gregdavill/icebreaker/hardware/bitsy-v0.3b/icebreaker-bitsy_back.jpg

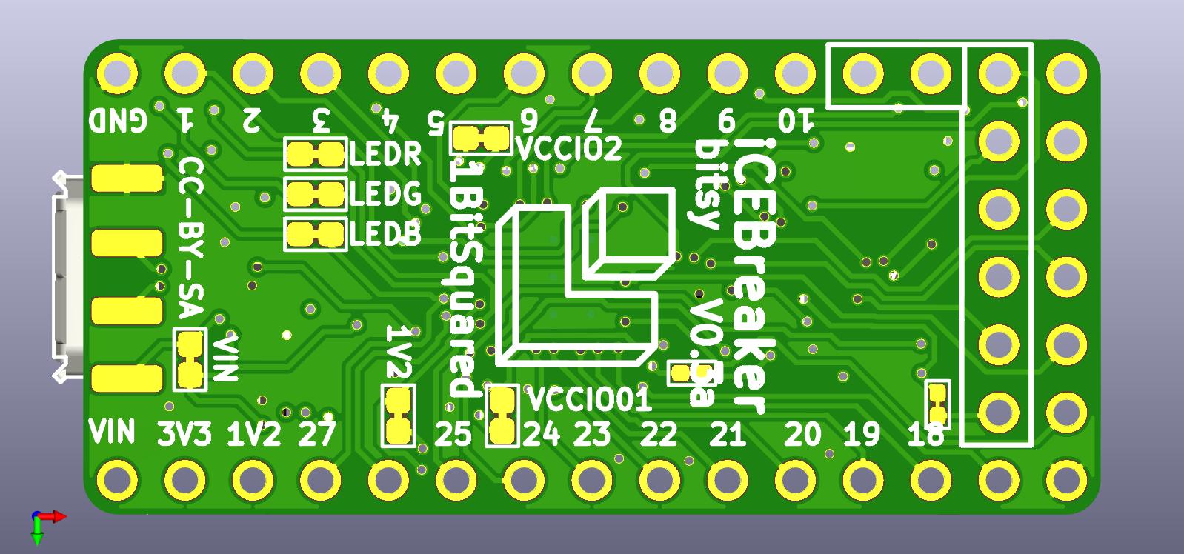
hardware/bitsy-v0.3b/icebreaker-bitsy_back.jpg
