gregdavill/icebreaker/hardware/bitsy-v0.3b/icebreaker-bitsy.jpg

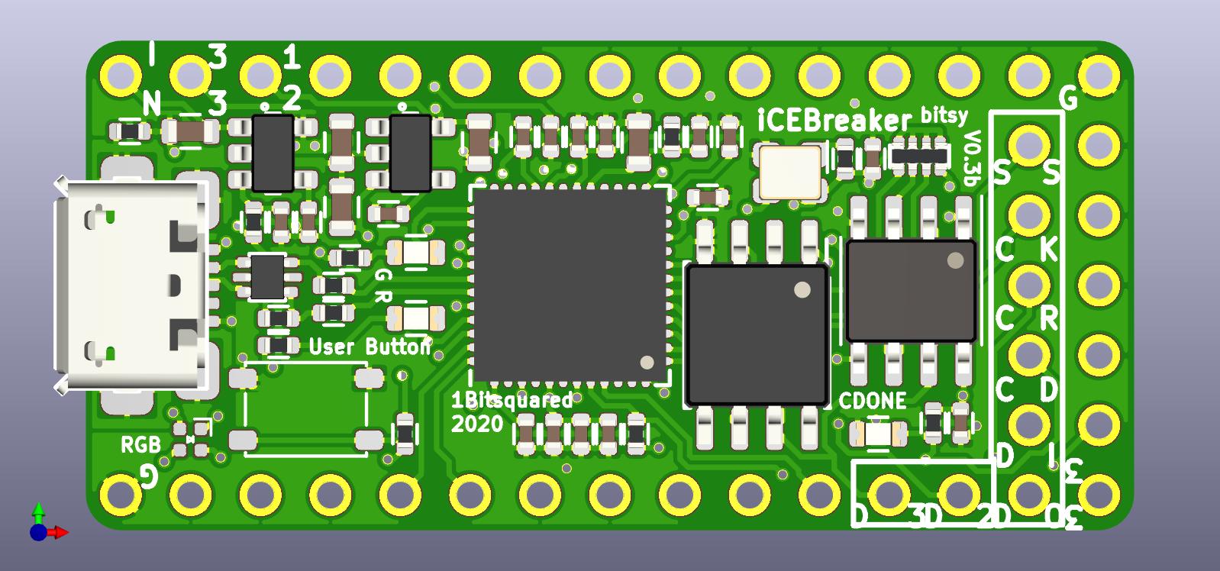
hardware/bitsy-v0.3b/icebreaker-bitsy.jpg
