gregdavill/icebreaker/hardware/bitsy-v0.3b/icebreaker-bitsy-sch.pdf

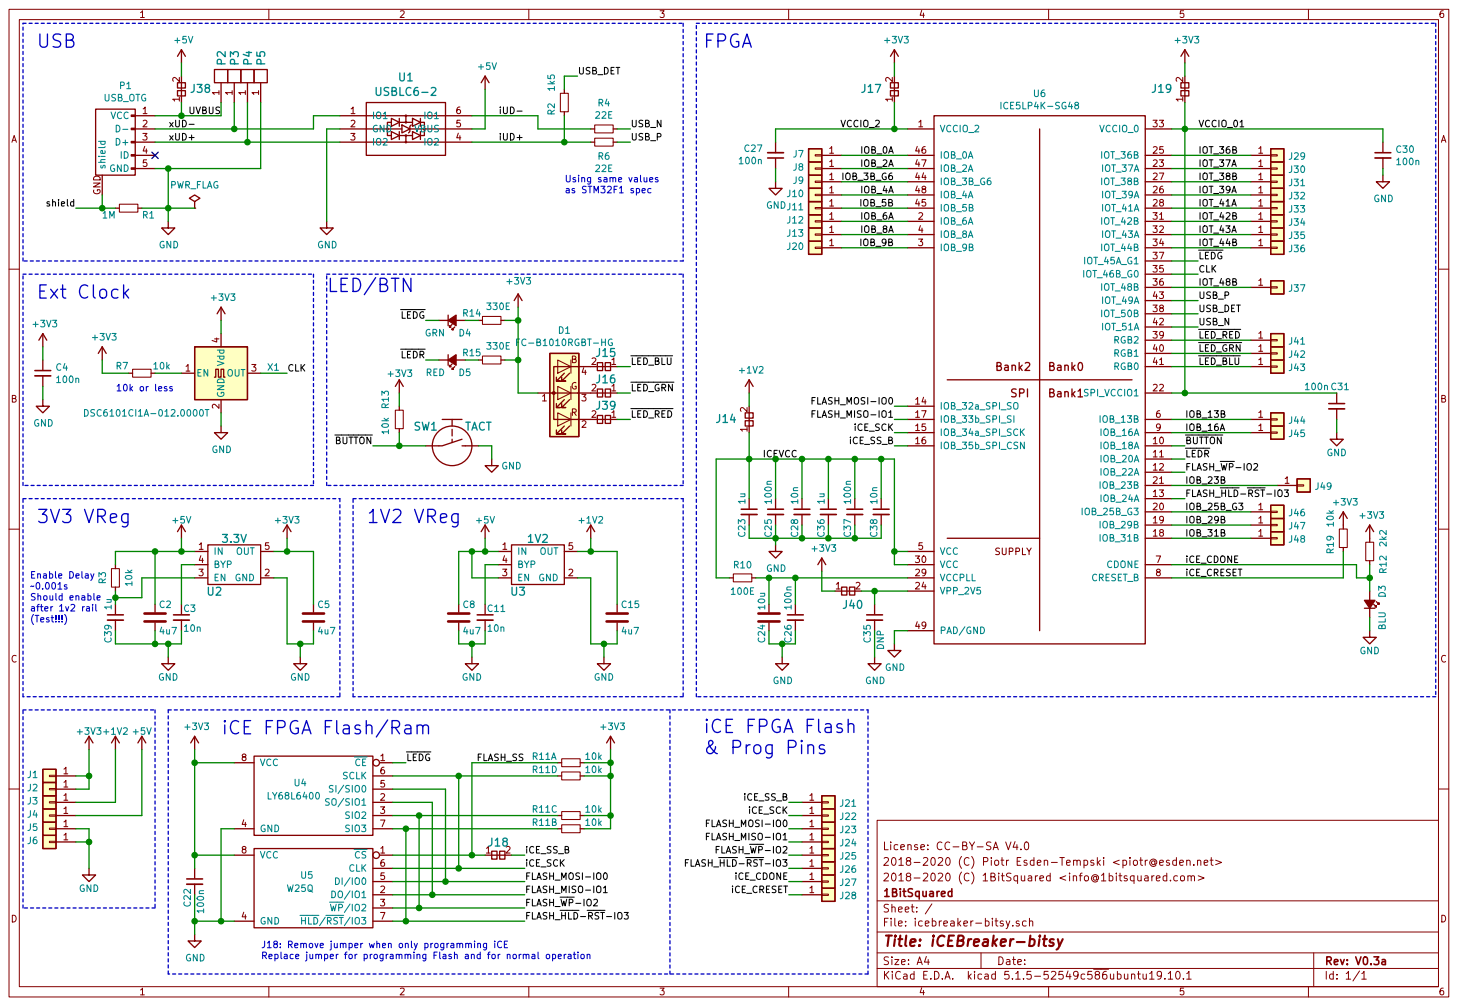
[picture p3: page 1]

LED_GRN 1
LED_BLU 1

Enable Delay 0.001s Should enable

iCE FPGA Flash/Ram

License: CC-BY-SA V4.0
2018-2020 (C) Piotr Esden-Tempski <piotr@esden.net>
2018-2020 (C) 1BitSquared <info@1bitsquared.com>
File: icebreaker-bitsy.sch Sheet: / 1BitSquared

Id: 1/1 Title: iCEBreaker-bitsy

J18: Remove jumper when only programming iCE
Replace jumper for programming Flash and for normal operation
