gregdavill/icebreaker/hardware/bitsy-v0.3b/icebreaker-bitsy.kicad_pcb

## KiCad design hardware/bitsy-v0.3b/icebreaker-bitsy.kicad_pcb (2020-04-05)

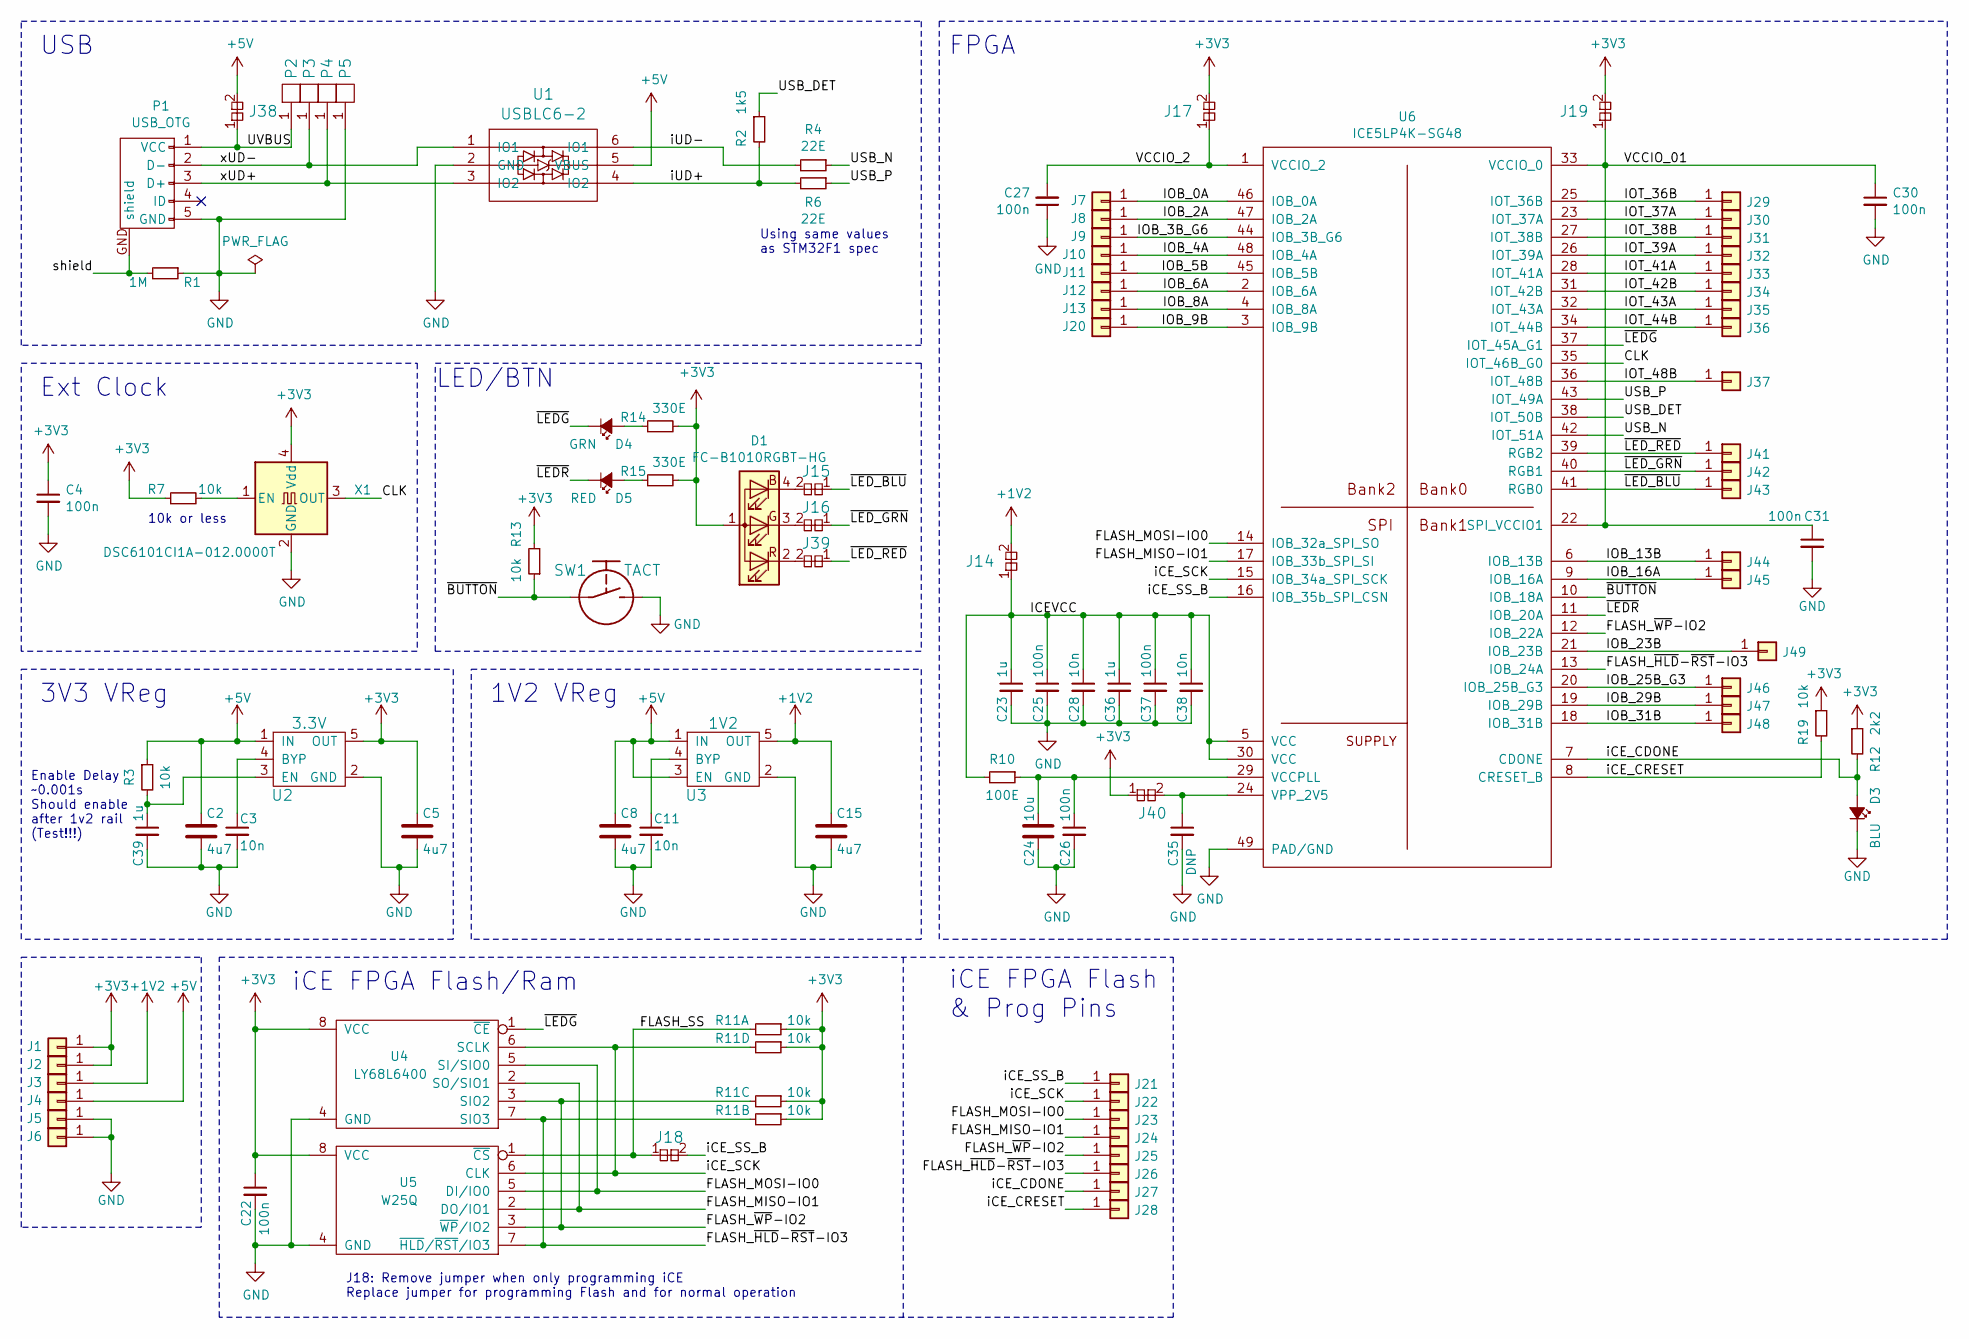
[picture p4: schematic icebreaker-bitsy.sch]

Parts:
C2, C5, C8, C15: 4u7; C_0603
C3, C11, C28, C38: 10n; C_0402
C4, C22, C25, C26, C27, C30, C31, C37: 100n; C_0402
C23, C36, C39: 1u; C_0402
C24: 10u; C_0603
C35: DNP; C_0402
D1: FC-B1010RGBT-HG; LED_TRI_1010
D3: BLU; D_0603
D4: GRN; D_0603
D5: RED; D_0603
J1, J2, J3, J4, J5, J6, J7, J8, J9, J10, J11, J12, J13, J20, J21, J22, J23, J24, J25, J26, J27, J28, J29, J30, J31, J32, J33, J34, J35, J36, J37, J41, J42, J43, J44, J45, J46, J47, J48, J49: Conn_01x01; Pin_Header_Straight_Round_1x01
J14, J15, J16, J17, J19, J38, J39: Jumper; J_NC_0603_30
J18, J40: Jumper; J_NC_0402_15
P1: USB_OTG; Connector_USB_Micro_B_SMD
P2, P3, P4, P5: UP; PAD_SMD_1x2.65
R1: 1M; R_0402
R2: 1k5; R_0402
R3, R7, R13, R19: 10k; R_0402
R4, R6: 22E; R_0402
R10: 100E; R_0402
R11: 10k; R_Array_Convex_4x0402
R12: 2k2; R_0402
R14, R15: 330E; R_0402
SW1: TACT; SW_SPST_3x4x2.5
U1: USBLC6-2; SOT-666
U2: 3.3V; SOT-23-5
U3: 1V2; SOT-23-5
U4: LY68L6400; SOIC-8_3.9x4.9mm_P1.27mm
U5: W25Q; SOIC-8_5.3x5.3mm_Pitch1.27mm
U6: ICE5LP4K-SG48; QFN-48-1EP_7x7mm_Pitch0.5mm
X1: DSC6101CI1A-012.0000T; Oscillator_SMD_SCTF_S2DXX-4Pin_2.5x2.0mm

Connections:
+1V2: C15.1, J3.1, J14.2, U3.5 (OUT)
+3V3: C4.1, C5.1, C22.1, D1.1 (A), J1.1, J2.1, J17.2, J19.2, J40.1, R7.1, R11.1, R11.3, R11.5, R11.7, R12.1, R13.2, R14.2, R15.2, R19.1, U2.5 (OUT), U4.8 (VCC), U5.8 (VCC), X1.4 (Vdd)
+5V: C2.1, C8.1, J4.1, J38.2, R3.1, U1.5 (VBUS), U2.1 (IN), U3.1 (IN), U3.3 (EN)
/CLK: U6.35 (IOT_46B_G0), X1.3 (OUT)
/FLASH_MISO-IO1: J24.1, U4.2 (SO/SIO1), U5.2 (DO/IO1), U6.17 (IOB_33b_SPI_SI)
/FLASH_MOSI-IO0: J23.1, U4.5 (SI/SIO0), U5.5 (DI/IO0), U6.14 (IOB_32a_SPI_SO)
/FLASH_SS: J18.1, R11.2, U5.1 (~CS)
/FLASH_~HLD~-~RST~-IO3: J26.1, R11.4, U4.7 (SIO3), U5.7 (~HLD~/~RST~/IO3), U6.13 (IOB_24A)
/FLASH_~WP~-IO2: J25.1, R11.6, U4.3 (SIO2), U5.3 (~WP~/IO2), U6.12 (IOB_22A)
/ICEVCC: C23.1, C25.1, C28.1, C36.1, C37.1, C38.1, J14.1, R10.2, U6.5 (VCC), U6.30 (VCC)
/IOB_0A: J7.1, U6.46 (IOB_0A)
/IOB_2A: J8.1, U6.47 (IOB_2A)
/IOB_3B_G6: J9.1, U6.44 (IOB_3B_G6)
/IOB_4A: J10.1, U6.48 (IOB_4A)
/IOB_5B: J11.1, U6.45 (IOB_5B)
/IOB_6A: J12.1, U6.2 (IOB_6A)
/IOB_8A: J13.1, U6.4 (IOB_8A)
/IOB_9B: J20.1, U6.3 (IOB_9B)
/IOB_13B: J44.1, U6.6 (IOB_13B)
/IOB_16A: J45.1, U6.9 (IOB_16A)
/IOB_23B: J49.1, U6.21 (IOB_23B)
/IOB_25B_G3: J46.1, U6.20 (IOB_25B_G3)
/IOB_29B: J47.1, U6.19 (IOB_29B)
/IOB_31B: J48.1, U6.18 (IOB_31B)
/IOT_36B: J29.1, U6.25 (IOT_36B)
/IOT_37A: J30.1, U6.23 (IOT_37A)
/IOT_38B: J31.1, U6.27 (IOT_38B)
/IOT_39A: J32.1, U6.26 (IOT_39A)
/IOT_41A: J33.1, U6.28 (IOT_41A)
/IOT_42B: J34.1, U6.31 (IOT_42B)
/IOT_43A: J35.1, U6.32 (IOT_43A)
/IOT_44B: J36.1, U6.34 (IOT_44B)
/IOT_48B: J37.1, U6.36 (IOT_48B)
/USB_DET: R2.1, U6.38 (IOT_50B)
/USB_N: R4.1, U6.42 (IOT_51A)
/USB_P: R6.1, U6.43 (IOT_49A)
/UVBUS: J38.1, P1.1 (VCC), P2.1
/VCCIO_01: C30.1, C31.1, J19.1, U6.22 (SPI_VCCIO1), U6.33 (VCCIO_0)
/VCCIO_2: C27.2, J17.1, U6.1 (VCCIO_2)
/iCE_CDONE: D3.A, J27.1, R12.2, U6.7 (CDONE)
/iCE_CRESET: J28.1, R19.2, U6.8 (CRESET_B)
/iCE_SCK: J22.1, R11.8, U4.6 (SCLK), U5.6 (CLK), U6.15 (IOB_34a_SPI_SCK)
/iCE_SS_B: J18.2, J21.1, U6.16 (IOB_35b_SPI_CSN)
/iUD+: R2.2, R6.2, U1.4 (IO2)
/iUD-: R4.2, U1.6 (IO1)
/shield: P1.GND (shield), R1.2
/xUD+: P1.3 (D+), P4.1, U1.3 (IO2)
/xUD-: P1.2 (D-), P3.1, U1.1 (IO1)
/~BUTTON: R13.1, SW1.1, U6.10 (IOB_18A)
/~LEDG: D4.C, U4.1 (~CE), U6.37 (IOT_45A_G1)
/~LEDR: D5.C, U6.11 (IOB_20A)
/~LED_BLU: J15.1, J43.1, U6.41 (RGB0)
/~LED_GRN: J16.1, J42.1, U6.40 (RGB1)
/~LED_RED: J39.1, J41.1, U6.39 (RGB2)
GND: C2.2, C3.2, C4.2, C5.2, C8.2, C11.2, C15.2, C22.2, C23.2, C24.2, C25.2, C26.2, C27.1, C28.2, C30.2, C31.2, C35.2, C36.2, C37.2, C38.2, C39.2, D3.C, J5.1, J6.1, P1.5 (GND), P5.1, R1.1, SW1.2, U1.2 (GND), U2.2 (GND), U3.2 (GND), U4.4 (GND), U5.4 (GND), U6.49 (PAD/GND), X1.2 (GND)
unnamed: C3.1, U2.4 (BYP)
unnamed: C11.1, U3.4 (BYP)
unnamed: C24.1, C26.1, R10.1, U6.29 (VCCPLL)
unnamed: C35.1, J40.2, U6.24 (VPP_2V5)
unnamed: C39.1, R3.2, U2.3 (EN)
unnamed: D1.2 (RK), J39.2
unnamed: D1.3 (GK), J16.2
unnamed: D1.4 (BK), J15.2
unnamed: D4.A, R14.1
unnamed: D5.A, R15.1
unnamed: R7.2, X1.1 (EN)

Notes on the sheet:
10k or less
J18: Remove jumper when only programming iCE Replace jumper for programming Flash and for normal operation
iCE FPGA Flash/Ram
FPGA
LED/BTN
3V3 VReg
1V2 VReg
Enable Delay ~~0.001s Should enable after 1v2 rail (Test!!!)
Using same values as STM32F1 spec
Ext Clock
USB
iCE FPGA Flash & Prog Pins

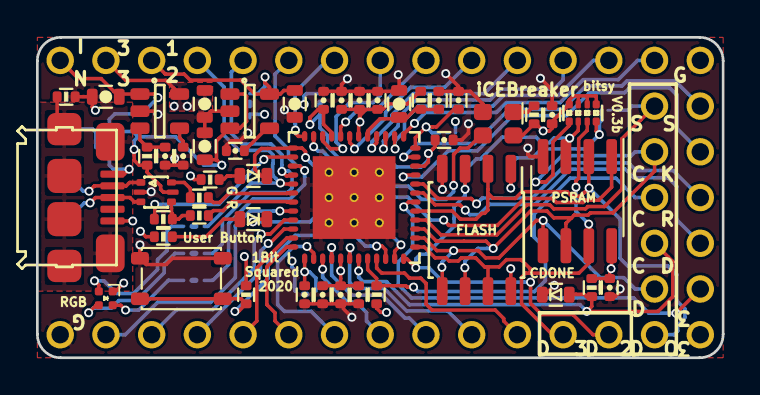
[picture p5: board icebreaker-bitsy.kicad_pcb from above]

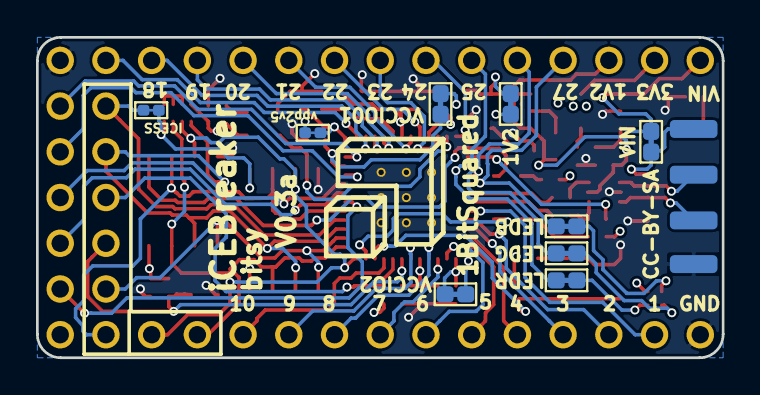
[picture p6: board icebreaker-bitsy.kicad_pcb from below]

Board: 4 copper layers, 38.1 x 17.8 mm, 100 parts (13 on the bottom side), 66 nets.
