gregdavill/icebreaker/(commit log)

2020-04-05 Minor cleanups, finishing up for prototype order.
    This is the status from the ad hoc stream from Apr 4th 2020.
    [icebreaker-bitsy.kicad_pcb, icebreaker-bitsy.sch]
2020-04-05 Quick route of single sided variant
    [icebreaker-bitsy.kicad_pcb, icebreaker-bitsy.sch]
2020-04-05 Clean up routing
    [icebreaker-bitsy.kicad_pcb]
