gregdavill/icebreaker/(notices)

Notices in the files:
hardware/bitsy-v0.3b/icebreaker-bitsy.kicad_pcb:
(C) 2018-2020 Piotr Esden-Tempski
(C) 2018-2020 1BitSquared
License: CC-BY-SA 4.0
